TymEK49/RTI_control/screenshots/screen1.png

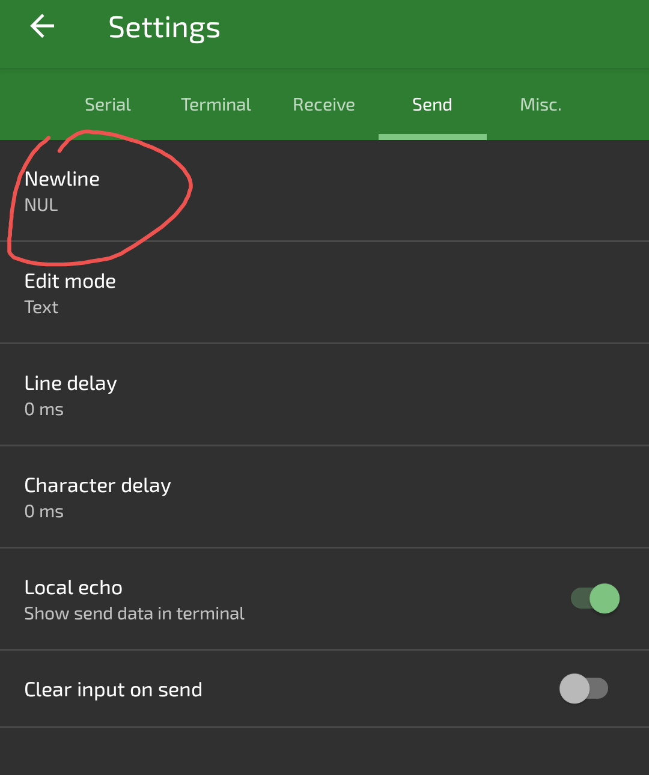
screenshots/screen1.png
