TymEK49/RTI_control/screenshots/screen2.png

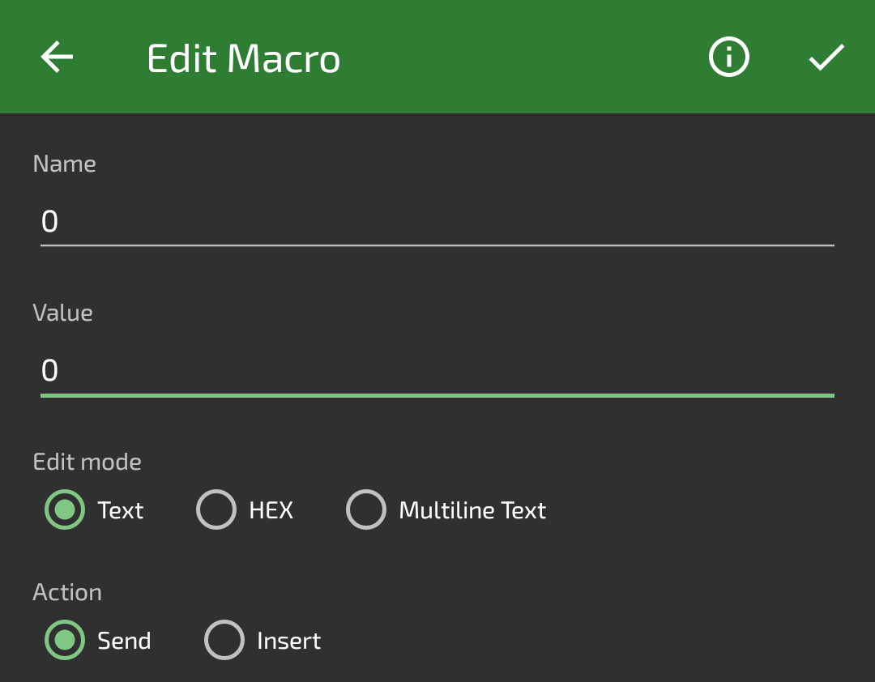
screenshots/screen2.png
