TymEK49/RTI_control/screenshots/screen4.png

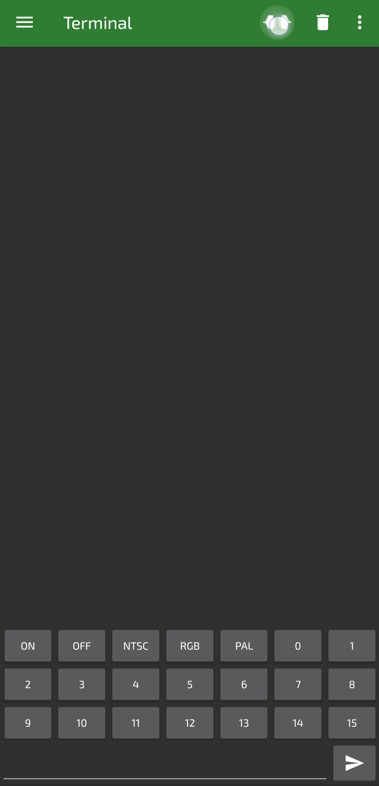
screenshots/screen4.png
