TymEK49/RTI_control/screenshots/screen5.png

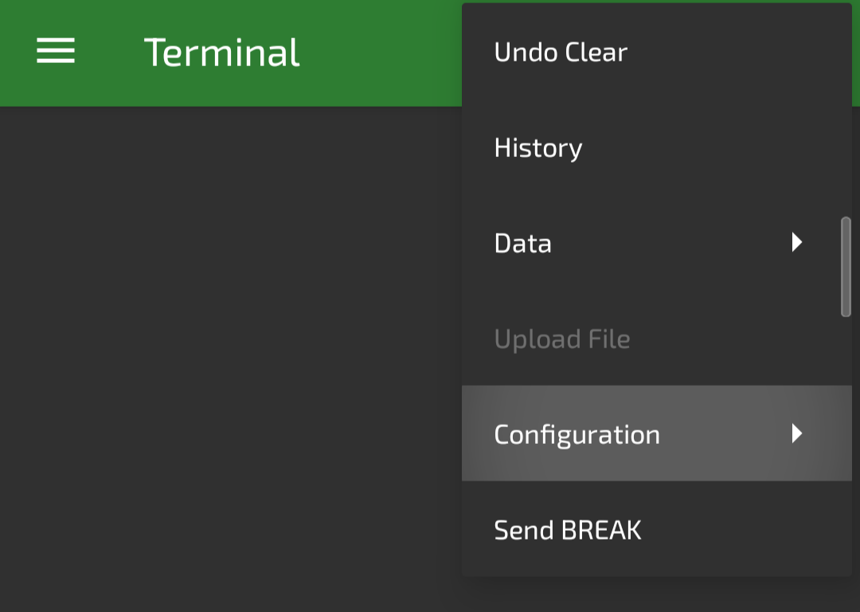
screenshots/screen5.png
