TymEK49/RTI_control/screenshots/screen6.png

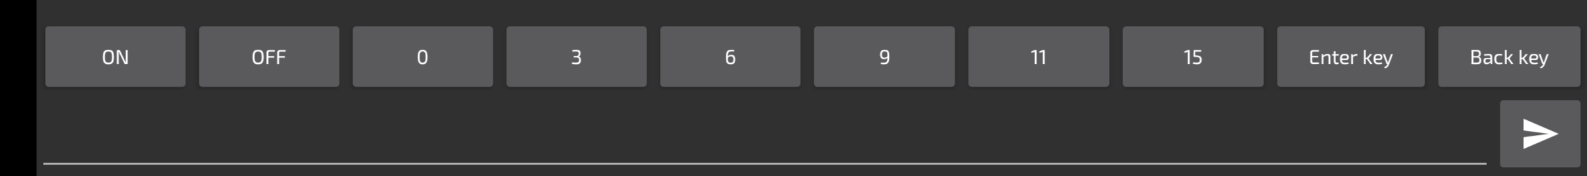
screenshots/screen6.png
