TymEK49/RTI_control/screenshots/screen7.png

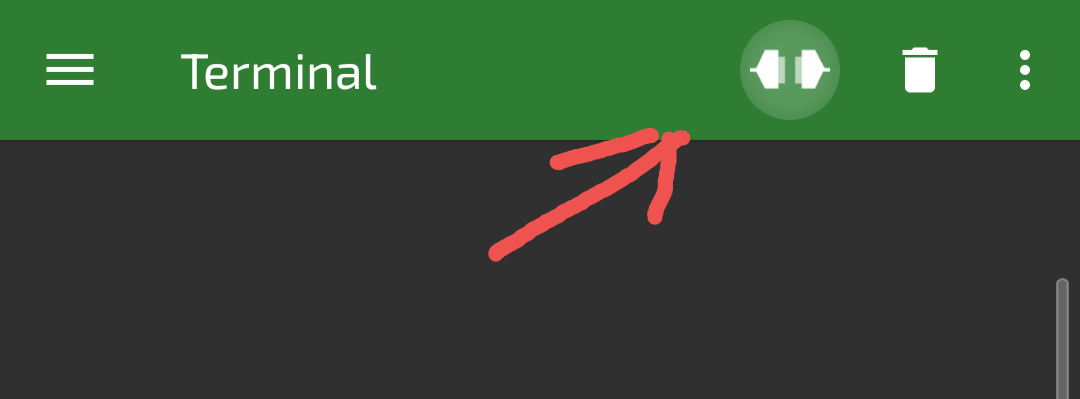
screenshots/screen7.png
