TymEK49/RTI_control/(threads)

Thread 3 (2023-08-29):

Requirements for adapter

itb3, 2023-08-29:
Not really an issue, but a question (already asked on FB but find the threading there confusing): what are the requirements for the usb2av adapter? Is something simple like this sufficient?
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

Thread 4 (2023-11-23):

Volvo s60

jacoqq, 2023-11-23:
Cześć,
Chciałbym zrobić coś takiego w S60 z 2009 roku z fabrycznym RTI. Czy jesteś w stanie potwierdzić, że Twój sketch zadziała na takim urządzeniu ? Pytam ponieważ próbowałem już projektu luuka (https://github.com/LuukEsselbrugge/Volve) i laurynassa (https://github.com/laurynas/volvo_crankshaft) i za nic nie mogę podnieść tego ekranu. Ty najlepiej opisałeś wszystko a mimo to też mi nie działa. Używam Arduino Micro Pro Leonardo i kod skompilował się bez problemu, na monitorze portu widzę reakcję na komendy, ale RTI ani drgnie. Wykluczam problem z połączeniem, bo sprawdzałem wszystko chyba ze sto razy. RTI też w porządku, bo podłączone w aucie działa bez problemu.
Będę bardzo wdzięczny za jakąkolwiek pomoc.

PS
Sorry, że po Polsku, ale tak mi lepiej wytłumaczyć :)

TymEK49, 2024-03-04:
Hej, powiedz mi czy jeszcze aktualne? dawno nie zaglądałem projekt i dopiero zobaczyłem wiadomość :)

jacoqq, 2024-03-06:
Szczerze mówiąc od tamtego czasu rzuciłem to w kąt, ale jeśli byłbyś w stanie mi coś podpowiedzieć to zerknę do tego na weekendzie i spróbuję jeszcze raz.
Dzięki za odpowiedź i zainteresowanie.

TymEK49, 2024-03-06:
Wiesz co, nie mogę znaleźć w dokumentacji jakie jest napięcie na uarcie w arduino leonardo - obstawiam, że tu moze być problem jesli daje 3.3v zamiast  5v. Jak masz dostęp do innej płytki byłoby najłatwiej sprawdzić.

jacoqq, 2024-03-06:
Dobrze, że mi przypomniałeś, bo kupiłem do tego nawet Konwerter poziomów napięć 3,3V / 5V i go nie sprawdziłem :). Muszę przysiąść w weekend i ponownie poskładać to do kupy. Pochwalę się wynikiem.

TymEK49, 2024-03-06:
koniecznie daj znać :) jeśli by się nie udało, będziemy dalej kombinować

jacoqq, 2024-03-11:
Sorry, że dopiero dzisiaj, ale ciężki weekend miałem. Zacznę od tego, że robiłem to na Arduino Micro Pro Leonardo oraz na ESP32 WROOM - na obu efekt był ten sam, czyli nie zadziałało. Ale fakt, że oba urządzenia na RX i TX napięcia mają 3,3 V. Tak jak pisałem wcześniej spróbowałem to podłączyć przez Konwerter poziomów napięć 3,3V/5V, zaznaczę, że nie jestem elektronikiem,  ale wydaje mi się. że podłączenie zgodnie ze schematem jakoś ogarniam
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
Niestety RTI w dalszym ciągu się nie podnosi. Zrobiłem więc pomiary napięcia za konwerterem i ku mojemu zdziwieniu tam gdzie podłączone są RX i TX (HV1 i HV2) napięcie dalej jest na poziomie 3,3V, a na pozostałych pinach (HV3 i HV4) jest 5V. Przełożyłem więc RX i TX pod inne piny i wtedy sytuacja jest odwrotna, zawsze na niepodłączonym pinie mam 5V, a gdy podłączam do niego RTI spada do 3,3 V. Nie wiem teraz czy źle coś podłączyłem, czy może mam uszkodzony konwerter, czy co jeszcze. Dodam tylko, że Arduino jest zasilane z Raspberry, więc GND jest wspólne, ale próbowałem też opcji z podaniem 5V z innego źródła i też nie działa.
Może masz jakiś pomysł ?

Thread 5 (2024-06-10):

RTI with green connector wiring

maklimcz, 2024-06-10:
Hello, i have a RTI with single green connector and I couldnt find a pinout scheme. Do you maybe have one?

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

maklimcz, 2024-08-22:
Hello, I can confirm that your code also works on my RTI.
Connections as in pictures.
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

remember that plug on scheme is on harness end. the plug in rti is mirror image. (pin1 is upper right)
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
screen quality is bad, therefore I'm going to search a 5inch display
