TymEK49/RTI_control/(commit log)

2022-07-15 Schemat
    How to wiring
2023-05-09 New app for ardino with remote
    - added OE remote support
    - added saving last state
    - changed USB commands
    - fixed brightness array
    - fixed typos
    [rti_control_with_remote.ino]
2023-05-09 Update rti_control_with_remote.ino
    quick fix for 'x' command
    [rti_control_with_remote.ino]
2023-05-10 Update rti_control_with_remote.ino
    Fixed (I hope) handling empty eeprom
    [rti_control_with_remote.ino]
2023-05-10 Update rti_control_with_remote.ino
    - removed useless 'else'
    - removed serial.println (this one was for development purpose)
2023-05-10 Update rti_control_with_remote.ino
    - fixed bug with enter/back saving
    [rti_control_with_remote.ino]
2023-05-12 fixed video cable
2024-03-04 Update rti_control_with_remote.ino
    Fixed bug with no saving screen state after USB command
    [rti_control_with_remote.ino]
